gauri149/MMA-Design/README.md

Design, Fabrication, and ML-Based Optimization of a High-Performance Metamaterial Absorber for Emerging Applications
